Hypha-ROS/hypharos_racecar/map/map_nav.png

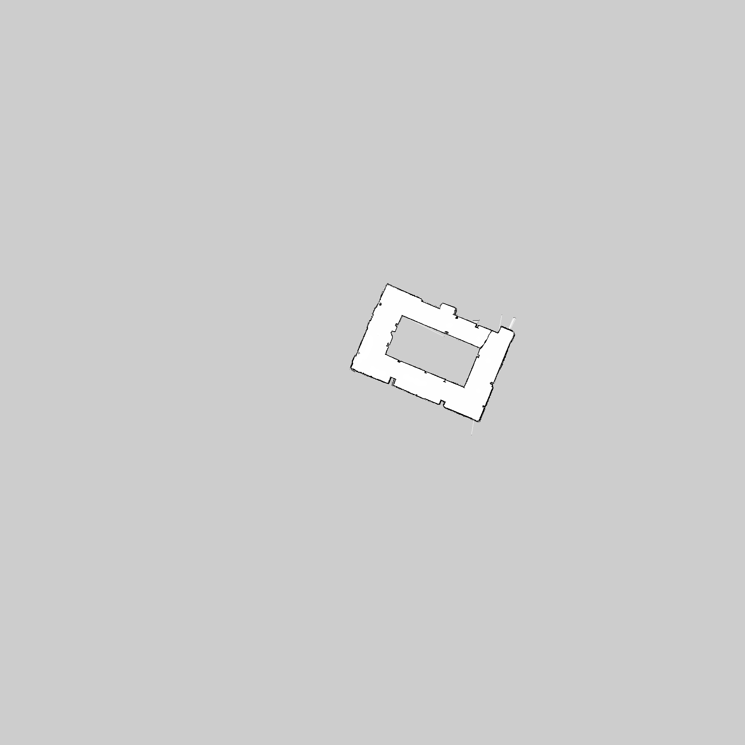
map/map_nav.png
