Hypha-ROS/hypharos_racecar/(threads)

Thread 3 (2017-11-21):

找不到文件imu_auto.py

DavidHan008, 2017-11-21:
<launch>
--
2 | <node name="imu_auto"   pkg="hypha_racecar"  type="imu_auto.py" output="screen">

找不到文件imu_auto.py

jim1993, 2017-11-23:
Hi @DavidHan008
the file "imu_auto.py" could be found in "hypha-racecar/script/".
I guess your problem is that you forgot to change the permission of the file to "executable".
You could try $ sudo chmod 755 imu_auto.py

jim1993, 2017-12-28:
I guess that this issue has been solved !

Closed 2017-12-28.

Thread 4 (2018-02-10):

Hardware

swapdha, 2018-02-10:
Here are my 2 question
(1)I have" HSP 94186" rc car , it is "1/16" scale , hardware similar to "HSP 94123" but it's small scale. I want to know can  i use "HSP 94186" instead of buying "HSP 94123" . I know it is smaller but i can manage with hardware intergartion.
(2)Have you change "HSP 94123" stock -esc with "TAMIYA ESC TBLE-02S" ,steering servo with
"FUTABA S9151 digital servo" and battery with "7.4v 5000 Mah battery"or you bought a empty 1/10 car frame and added all this parts mentioned in build doc pdf-"https://github.com/Hypha-ROS/hypha-racecar/blob/ver.1-release/document/Hypha-ROS-RaceCar-Tutorial_V1.1.pdf"

jim1993, 2018-02-12:
Hi @swapdha
For your questions, please find detail as below:
1. Definitely yes, actually, we are moving all source codes to our new 1/20 scaled minicar platform.
The thing you need to take care is that you have modify car related parameters in launch file
(e.g. the length of car for L1 controller, etc)

2. Yes, since the performance of ESC sent with HSP 94123 is pretty bad, we decided to use TAMIYA ESC.
But we also tested with hobbywing brushless ESC in our RaceCar ver2. For the servo, you can replace it with any digital based one.

Please feel free to comment here if you have any question.
HaoChih

swapdha, 2018-02-12:
Is it ok to use all stock parts(esc,sterring servo,battery) of HSP 94186  or I need to change.

subodh-malgonde, 2018-06-26:
@jim1993 Looking forward to the setup guide for 1/20 scale car. Can you give us an idea when you will release it?

I have a question about the weight of electronics - will the chassis and suspension of a 1/20 scale car be able to carry the same SBC, lidar, battery and camera as that for a 1/10 scale car? Can you please share the bill of materials for the 1/20 scale car?

jim1993, 2018-06-26:
Hi @subodh-malgonde
About the 1/20 scale car (we called HyphaROS minicar), well, currently we are working on porting custom MPC (model predictive controller) node to odroid xu4 environment. So if everything is on schedule, we could release our first beta version by the end of August (I hope so :D ).

For the hardware architecture, we still use odroid xu4 as SBC, plus YDLidar X4 for localization and STM32 MCU for motor speed and servo control (our minicar is ackermann design with encodered rear-wheel drives).

subodh-malgonde, 2018-06-28:
Thanks for getting back @jim1993. I have a couple more questions, if you don't mind.

1. If I may ask, which 1/20 model are your using?

2. Why is Ackermann design important? I know that full sized cars have Ackermann design. However why is that important for a smaller scale version which is likely to be used indoors?

jim1993, 2018-06-29:
Hi
I'm glad you asked:
1. We took a low-cost ackermann scaled model car from Taobao, then add lidar and odroid on it:
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

2. Good question :D
As you mentioned, for small platform, differential drive is quite enough, so it is one of reasons we created the "HyphaROS-MiniBot", which is exactly a different drive ROS based robot.
However, my background is "Control & Dynamic", therefore, I want to implement what I have learned from theories on real platform. For example: pure pursuit, model predictive control, LQR, etc. To illustrate these advanced control laws on this kind of low-cost car could be a great as well as affordable way for students to learn and experience what are the physical meaning of those algorithms taught by Profs or lecturers.
In short: just for fun ~~~!!!

subodh-malgonde, 2018-07-02:
You are awesome 🥇 Thank you so much for answering my questions in such a great detail 👍

Closed 2018-02-12.

Thread 7 (2018-05-08):

Timed out waiting for transform from base_footprint to map to become available before running costmap, tf error: canTransform: target_frame map does not exist.. canTransform returned after 0.100223 timeout was 0.1.

Maxesss, 2018-05-08:
Timed out waiting for transform from base_footprint to map to become available before running costmap, tf error: canTransform: target_frame map does not exist.. canTransform returned after 0.100223 timeout was 0.1.
查看了一下 rosrun tf view_frame map跟odom沒有被amcl發出

jim1993, 2018-05-09:
Hi @Maxesss
Based on my experience, the cause of this issue generally came from "scan" topic.
Could you please check if the scan topic is published or not?
$ rostopic hz /scan

jim1993, 2018-05-21:
I supposed this issue has been solved!

hakancan14, 2021-10-08:
> Merhaba @Maxesss Tecrübelerime dayanarak, bu sorunun nedeni genellikle "tarama" konusundan geldi. Lütfen tarama konusunun yayınlanıp yayınlanmadığını kontrol eder misiniz? $ rostopik hz /taram
i got the same error. When I run this code it says 'no new messages'. What should I do

Closed 2018-05-21.

Thread 8 (2018-06-26):

IMU to Odroid XU4

subodh-malgonde, 2018-06-26:
First of all, thank you for maintaining this repository 👍 . I am building a 1/10 scale autonomous but I am constrained on budget. This repository is exactly what I needed.

I was looking at the [Hypha ROS RaceCar Tutorial V1.1.pdf](https://github.com/Hypha-ROS/hypharos_racecar/blob/ver.1-release/document/Hypha-ROS-RaceCar-Tutorial_V1.1.pdf) and I noticed that you use an Arduino Nano as an interface between the GY85 IMU and Odroid XU4. If I use a [Razor 9DOF IMU](https://www.sparkfun.com/products/14001) which has a micro USB slot, can I simply use a microUSB to USB connector and connect the IMU to the USB hub?

jim1993, 2018-06-26:
Hi
Thank you for being interested in this repo.
For the IMU, yes, in our prototype version, we used Razor 9DOF IMU for yaw estimation.
The reason we adopt gy85 is because it is much cheaper :D

Closed 2018-06-27.

Thread 9 (2018-07-30):

RPLidar Connection

subodh-malgonde, 2018-07-30:
Hi,

I am using RPLidar A1. Your tutorial recommends using a separate power supply for the motor. The motor supply has 3 pins - `GND`, `VMOTO` and `MOTOCTL`. `VMOTO` is DC voltage between 5-10 V. `MOTOCTL` is the PWM control signal for the motor. Here is a screenshot from the datasheet.

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

The PWM signal is generated by the circuit board provided by Slamtec (manufacturer of RPLidar).
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

However I noticed from your tutorial that you are using only 2 pins (RX/TX) from the board. See this:

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

Your block diagram also suggests 2 pins.
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

Initially I thought that if I don't connect the `MOTOCTL` pin then maybe the motor will run at its default speed. However when I tried this the motor did not start. How are you generating the `MOTOCTL` PWM?

jim1993, 2018-07-30:
Hi @subodh-malgonde

About the connection of lidar, the order of pins defines as the first figure you post above:
GND: 5V BEC (-)
TX: to FTDI (USB)
RX: to FTDI (USB)
V5: 5V BEC (+)
----------
GND: Dc2Dc (-)
DTR: Dc2Dc (+)
V5: Dc2Dc (+)
In this case, the motor speed is actually controlled by Dc2Dc voltage instead of pwm
DTR and V5 are in the same voltage means that DTR is in 100% duty cycle pwm, which is equal to max V5 voltage. So, you can change the voltage of V5 to modify the motor speed!

subodh-malgonde, 2018-07-31:
Thank you so much @jim1993! 👍 It is clear now. If I want to vary the duty cycle then I can use a potentiometer to reduce the voltage.

jim1993, 2018-08-02:
Hi
As you said, you can connect battery to motor pins.
The reason for using dc2dc module is that we could modify the rotation speed of lidar (Hz) by changing the input voltage.

subodh-malgonde, 2018-08-02:
The frequency is controlled by DTR voltage, right? If DTR and V5 are same then the frequency will be maximum. What am I missing?

jim1993, 2018-08-04:
Yes, If DTR and V5 are same then the frequency will be maximum.
However, the max freq depends on V5 voltage.
If the input volt is 5V, then max freq is around 5Hz.
For higher freq, it needs higher input voltage (max tolerance is 9V)

leizhao3, 2020-11-17:
Hi @haochihlin , thank you so much for your team's hard work! I would like to reach out that is there any special reason you team also power the core separately (from the USB)? What's the trade off if use the FTDI to power the core (instead of separate power source)?

Closed 2018-07-31.

Thread 10 (2019-03-25):

Have you ever meet the question that odomertry got from rf2o drifts?

Octalivia, 2019-03-25:
When the racecar have a greater acceleration to speed up or brake, the odometry will drift even when it is still after applying the brake. So I check the odometry got from rf2o, and it drifts. I wonder have you ever met this problem and how to deal with it?

Octalivia, 2019-03-26:
I think that the problem is not because of rf2o. I found it worked well when drifting, maybe the reason is the AMCL location lost

haochihlin, 2019-03-27:
Hi @Octalivia,
Thanks for being interested in this project.
About the drifting issue, based on my understanding, it has several causes:
1. The constant speed assumption held by rf2o:
In the paper of rf2o, it assumed there is no sudden acceleration changes. We have tested it in quick accelerate/de-accelerate situation, the drifts of odometry outputs could be observed easily.

The best way to solve it is to add wheel odometry (encoder based). So this is why we launched the other project called "HyphaROS-minicar". Since the new platform provides wheel odometry which make us be able to implement advanced controller on it (e.g. 2 layers MPC)

Or you can use state-of-art VIO(e.g. ROVIO, SVO, etc) to replace laser based odometry.

2. The parameters (or performance) of AMCL:
Because the "HyphaROS-racecar" project was launched almost two years ago without recent updates. If I don't remember wrong, the parameters tuning of amcl in this repo was not the optimal ones. You can take the updated (fine-tuned one) parameters from "HyphaROS-minicar".

The other potential solution would be, again, using VIO for localization (e.g. ROVIOLI)

Cheers,
HaoChih, Lin

Octalivia, 2019-03-27:
Thank u @haochihlin
I aprreciate the information and advice you have provided. The problem was partially resolved by changing the amcl.launch.xml. Although particle cloud dispersion still happens after the brake, the odom doesn't drift like it used to be.   I will optimize the parameters to make it better. By the way, the documents have mentioned the speed of the racecar is up to 3m/s. Is it encoder-based or not？
Best regards,
Octalivia

haochihlin, 2019-03-27:
Yes, the video you saw in the readme was based on rf2o odometry.

Octalivia, 2019-04-05:
The amcl parameters only helps when rotating. I found the velocity from rf20 is 0 after the brake, but the odometry filtered by ekf publish that its velocity is still 1.5 m/s. Is seems the ekf is the reason. I'm sorry that I asked a wrong question.

Closed 2019-04-05.

Thread 12 (2019-04-09):

Copy error messages

speronig, 2019-04-09:
hi I am trying to upload the code to the arduino nano but it is giving me all these copy error messages. I'm kinda new to arduino and I was wondering if anyone knew how to solve it.
Thank you

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

haochihlin, 2019-04-12:
Hi @speronig,

If you are using GY85 or razor-imu, I suggest you follow the tutorial in the following link:
http://wiki.ros.org/razor_imu_9dof

Or I remember our documentation should also mention how to load the firmware to arduino.

Cheers,
HaoChih, Lin

speronig, 2019-04-15:
Hi @haochihlin ,
Thank you for your answer. I am using a GY-85, and even after following the tutorial I still get the same mistake. Could it be because I'm using an Arduino Nano instead of a Pro like is said in the tutorial?

Thank you

speronig, 2019-04-15:
Nevermind @haochihlin  I made a rookie mistake.

Closed 2019-04-25.

Thread 14 (2019-04-25):

CLaserOdometry2D.cpp

r290085, 2019-04-25:
您好:
首先，我發現mapir-ros-pkgs這個pkg已經不支援而且catkin_make會報錯，所以我使用rf2o_laser_odometry這個更新過的pkg可以成功編譯ws.

之後我按照toutorial_V1.1 replace rf2o檔案卻無法再次成功編譯ws.
Error顯示在CLaserOdometry2D.cpp 這個取代過的檔案.
我想是否因為其他pkg的更新導致取代檔案已經無法使用?請問我該如何修改呢 謝謝!

haochihlin, 2019-05-11:
你好
確實像你所描述的 更新版的rf2o_laser_odometry應該可行

至於你說的compile issue 我建議你先catkin clean後 再重新compile

r290085, 2019-05-13:
你好 感謝你的回覆
另外想再請教使用gmapping建置地圖的問題。
我目前使用的是gmapping建圖，車子在行進及轉彎時必須非常慢否則會產生地圖重疊或偏移，請問文件裡提供的地圖也是用gmapping建置的嗎? 謝謝!

Closed 2019-05-11.

Thread 15 (2019-04-28):

Error while running Test_gmapping.launch  file

MahnoorZaghum, 2019-04-28:
Hello! I am having this error continuously while running Test_gmapping.launch file. Btw I am new to ROS and trying to build your project.
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

Any help will be highly appreciated.

haochihlin, 2019-05-11:
Hi
For your case, it's hard for me to figure out the exact cause.
Maybe the issue came from the rplidar driver.

Closed 2019-07-26.

Thread 16 (2019-05-01):

Catkin_make error

speronig, 2019-05-01:
hi when i try to run the catkin_make comand at the end of the 'Initial Settings' page in the tutorial, I get this error:

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

any help?

speronig, 2019-05-02:
also I'm getting this error:

/home/giambo/catkin_ws/src/mapir-ros-pkgs/src/rf2o_laser_odometry/src/CLaserOdometry2D.cpp:900:29: error: no match for ‘operator+’ (operand types are ‘mrpt::poses::CPose3D’ and ‘mrpt::poses::CPose2D’)
     laser_pose = laser_pose + pose_aux_2D;

which i think it is where it all starts

haochihlin, 2019-05-11:
Hi
The error seems came from rf2o_laser_odometry.
In this repo, we used an early version of rf2o_laser_odometry, which has some bugs insides.
Therefore, we add some patches in the forked folder.
You can find the fixed file as below:
https://github.com/Hypha-ROS/hypharos_racecar/tree/ver.1-release/document/replace_files/rf2o

Please find the "Document Replacement" on page 13 of the tutorial:
https://github.com/Hypha-ROS/hypharos_racecar/blob/ver.1-release/document/Hypha-ROS-RaceCar-Tutorial_V1.1.pdf

leizhao3, 2020-12-23:
Hi All, I also encountered the same issue when I was trying to catkin_make Hypharos_racecar recently. Here is my solution & it works out for me:

Step 1: Copy all other files to catkin_ws/src, followed by the code below:
`
~catkin_ws/src: git clone https://github.com/MAPIRlab/rf2o_laser_odometry # Not from "https://github.com/MAPIRlab/mapir-ros-pkgs.git" from the documents since that repo is retired.
~catkin_ws/src: cd ..
~catkin_ws: catkin_make
`

Step 2: Document replacement as mentioned by @haochihlin

Step 3: Rebuild the workspace again:
`~catkin_ws: catkin_make`

Closed 2019-05-11.

Thread 17 (2019-05-02):

/move_base_node/NavfnROS/plan

001SCH, 2019-05-02:
Hi,I wonder if / move_base_node/NavfnROS/plan belongs to global_planner?
And I couldn't find the location in the code where it was published，I hope you could solve my problem.

haochihlin, 2019-05-11:
Hi
As I recall correctly, then yes, move_base_node/NavfnROS/plan belongs to global_planne.
The path was published by standard move_base plugin

001SCH, 2019-05-12:
Thank you for your answer. I have understood this implementation process. In addition, after I raised the speed to 2m/s, the steering of the car is not timely enough, easy to collide, how should this be solved?

001SCH, 2019-05-17:
Hi.
I'm sorry to bother you again. I don't quite understand the role of the Angle_gain parameter in L1_controller_v2.cpp. Why not directly use the predicted angle, but multiply it by a multiple? In addition, I have referred to MIT's paper on closed-loop prediction and still do not understand how to adjust the parameters. Do you have any good suggestions?

发送自 Windows 10 版邮件应用

发件人: Hao-Chih, Lin
发送时间: 2019年5月12日 3:15
收件人: Hypha-ROS/hypharos_racecar
抄送: 001SCH; Author
主题: Re: [Hypha-ROS/hypharos_racecar] /move_base_node/NavfnROS/plan (#17)

Hi
As I recall correctly, then yes, move_base_node/NavfnROS/plan belongs to global_planne.
The path was published by standard move_base plugin
—
You are receiving this because you authored the thread.
Reply to this email directly, view it on GitHub, or mute the thread.

Closed 2019-05-11.

Thread 18 (2019-06-11):

Car footprint cannot follow radar

001SCH, 2019-06-11:
When my racecar is running, in rviz, the obstacles scanned by radar often change (because the car is moving), but the footprint of the car does not move,And no problem of TF transformation has been found.I guess there is a problem with rf2o, but there is no solution yet. Do you have any suggestions?

haochihlin, 2019-07-26:
Hi @001SCH ,
I think the problem came from the rf2o pkg.
As I recalled correctly, they have released the new official rf2o pkg.
Unfortunately, I have neither a racecar nor time to test the latest version of rf2o pkg.

Closed 2019-07-26.

Thread 19 (2019-07-18):

the relationship of Lfw & Vcmd

TangHengxuan, 2019-07-18:
May I ask why the variable Lfw equals to (Vcmd*2.24)/3.
I learnd from other pages that selected Lfw = Vcmd*2.24.
Thank you so much , I am confused a lot.  Looking forward to your answer！！

haochihlin, 2019-07-26:
Hi @TangHengxuan ,
As you mentioned, the value depicted in the paper is Lfw = Vcmd2.24.
However, it assumed there is a closed loop controller on car velocity.
In racecar (ver.1), we can not measure the car velocity directly, so we tuned the Lfw value by trail and errors.

Closed 2019-07-26.

Thread 21 (2020-10-06):

The name of brushed motor and ESC issue

zanpozane, 2020-10-06:
Hello! So now i try to make and build race car V.1 based on your tutorial workshop. I want to ask,  i have ESC TBLE-02S before but the motor can't move forward (just backward, right, and left).  When i tried to troubleshoot, then the ESC broken and burned inside. So do you know what happen and why?
And By the way what is your brushed motor name and type that you used?

haochihlin, 2020-10-06:
Hi @zanpozane ,
For TBLE-02S ESC, I suggest you to read the its official documentation directly.
(there are different mode: brushed or brushless)
Since you are using the brushed motor, you can just simply change the motor wires....

For the brushed motor, we used the default one in the TAMIYA car kit.

Closed 2020-10-06.
