Hypha-ROS/hypharos_racecar/script/imu_auto.py

#!/usr/bin/env python
# Copyright (c) 2017, HaoChih LIN
# All rights reserved. (Hypha ROS Workshop)
# 
# This file is part of hypha_racecar package.
#
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
import rospy
import serial
import string
import math
import sys

from sensor_msgs.msg import Imu
from tf.transformations import quaternion_from_euler

### ------------- ###
### ROS Node Init ###
### ------------- ### 
rospy.init_node("imu_auto_cali_node")
pub = rospy.Publisher('/imu_data', Imu, queue_size=1)
imuMsg = Imu()

# Orientation covariance estimation:
imuMsg.orientation_covariance = [
0.0025 , 0 , 0,
0, 0.0025, 0,
0, 0, 0.000025
]

# Angular velocity covariance estimation:
imuMsg.angular_velocity_covariance = [
0.02, 0 , 0,
0 , 0.02, 0,
0 , 0 , 0.02
]

# linear acceleration covariance estimation:
imuMsg.linear_acceleration_covariance = [
0.04 , 0 , 0,
0 , 0.04, 0,
0 , 0 , 0.04
]

### -------------- ###
### Get parameters ###
### -------------- ### 
# IMU frame
imu_frame = rospy.get_param('~imu_frame', 'IMU_link')

# device port
port = rospy.get_param('~port', '/dev/gy85')

# baudrate
baudrate = rospy.get_param('~baudrate', 57600)


# Check your COM port and baud rate
rospy.loginfo("Opening %s...", port)
try:
    ser = serial.Serial(port=port, baudrate=baudrate, timeout=1)
except serial.serialutil.SerialException:
    rospy.logerr("IMU not found at port "+port + ". Did you specify the correct port in the launch file?")
    #exit
    sys.exit(0)

rospy.loginfo("Giving the razor IMU board 5 seconds to boot...")
rospy.sleep(5) # Sleep for 5 seconds to wait for the board to boot

### configure board ###
#stop datastream
ser.write('#o0' + chr(13))

#discard old input
#automatic flush - NOT WORKING
#ser.flushInput()  #discard old input, still in invalid format
#flush manually, as above command is not working
discard = ser.readlines() 

#start datastream
ser.write('#ox' + chr(13)) # To start display angle and sensor reading in text
ser.flushInput()
ser.write('#o1' + chr(13))

#automatic flush - NOT WORKING
#ser.flushInput()  #discard old input, still in invalid format
#flush manually, as above command is not working - it breaks the serial connection
rospy.loginfo("Flushing first 200 IMU entries...")
for x in range(0, 200):
    line = ser.readline()


### -------------------- ###
### Auto yaw-calibration ###
### -------------------- ### 
rospy.loginfo("Auto yaw calibration...")
count = 0.0
vyaw_sum = 0.0
yaw_rad = 0.0
for x in range(0, 300):
    try:
        line = ser.readline()
        line = line.replace("#YPRAG=","")   # Delete "#YPRAG="
        words = string.split(line,",")    # Fields split
        vyaw_sum = vyaw_sum + float(words[8])
        count = count + 1.0
    except:
	    rospy.logwarn("Error in Sensor values")
	    pass

vyaw_bias = float(vyaw_sum/count)
rospy.loginfo("Bias of Vyaw is(rad): %f", vyaw_bias)

### --------------- ###
### Publishing data ###
### --------------- ### 
rospy.loginfo("Publishing IMU data...")
current = rospy.get_time()
last = current
dt = 0.0
seq = 0
while not rospy.is_shutdown():
    try:
        line = ser.readline()
        line = line.replace("#YPRAG=","")   # Delete "#YPRAG="
        words = string.split(line,",")    # Fields split

        yaw_rad = -( float(words[8]) - vyaw_bias )*dt + yaw_rad
        if (yaw_rad < -math.pi):
	        yaw_rad += 2*math.pi
        if (yaw_rad > math.pi):
	        yaw_rad -= 2*math.pi
        current = rospy.get_time()
        dt = current - last;
        last = current
        #rospy.loginfo("[debug] yaw(rad): %f", yaw_rad)
        q = quaternion_from_euler(0,0,yaw_rad)
        imuMsg.orientation.x = q[0]
        imuMsg.orientation.y = q[1]
        imuMsg.orientation.z = q[2]
        imuMsg.orientation.w = q[3]
        imuMsg.header.stamp= rospy.Time.now()
        imuMsg.header.frame_id = imu_frame
        imuMsg.header.seq = seq
        seq = seq + 1
        pub.publish(imuMsg)
  
    except:
	    rospy.logwarn("Error in Sensor values")
	    pass
ser.close
#f.close
