Hypha-ROS/hypharos_racecar/(commit log)

2017-06-12 fix imu
2017-06-20 add sample
2017-09-05 add stage launch
2017-09-19 20170919 Implement reversing Kai Changes to be committed: modified: readme.md modified: script/racecar_teleop.py
    [racecar_teleop.py]
2017-12-30 Update readme.md
    Update the link for rf2o odometry repo.
