Hypha-ROS/hypharos_racecar/(notices)

Notices in the files:
script/imu_auto.py:
hypha_racecar is free software: you can redistribute it and/or modify
it under the terms of the GNU LESSER GENERAL PUBLIC LICENSE as published
